PierreHlr/nfc-business-card/Carte_NFC_KiCad/production/bom.csv

Designator | Footprint | Quantity | Value | LCSC Part #
C1, C2 | 0603 | 2 | DNP
U1 | NXP_HXSON-4-1EP_1.5x2mm_P0.5mm | 1 | NT2H1311F0DTLH | C2654853
