PierreHlr/nfc-business-card/Carte_NFC_KiCad/Carte_NFC_KiCad.kicad_pcb

## KiCad design Carte_NFC_KiCad/Carte_NFC_KiCad.kicad_pcb (2026-09-30)

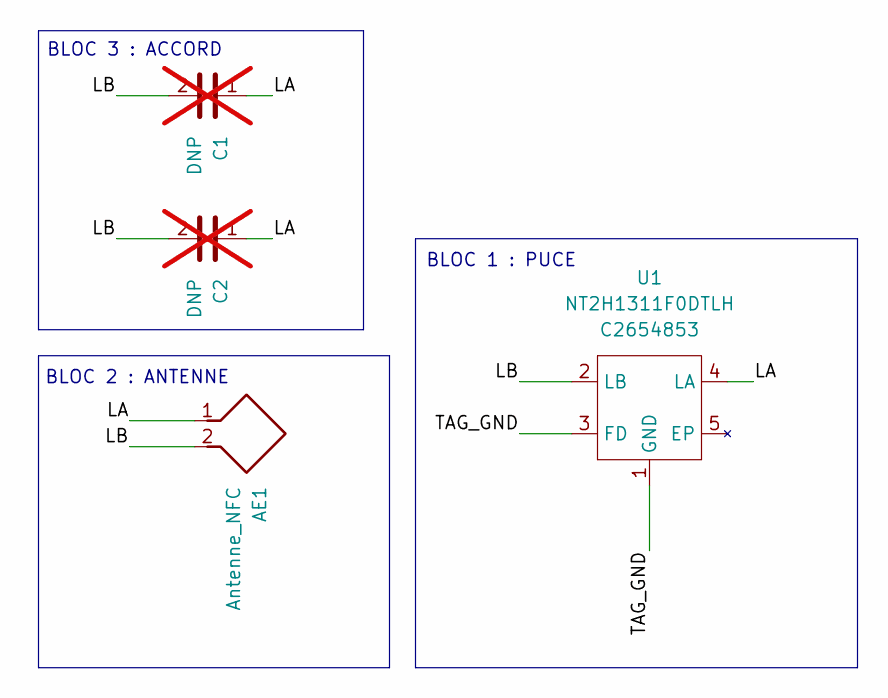
[picture p4: schematic Carte_NFC_KiCad.kicad_sch, Carte NFC]

Parts:
AE1: Antenne_NFC; Antenne_NFC_80x48mm_4T
C1, C2: DNP; C_0603_1608Metric; not fitted
U1: NT2H1311F0DTLH; NXP_HXSON-4-1EP_1.5x2mm_P0.5mm; LCSC C2654853

Connections:
/LA: AE1.1, C1.1, C2.1, U1.4 (LA)
/LB: AE1.2, C1.2, C2.2, U1.2 (LB)
/TAG_GND: U1.1 (GND), U1.3 (FD)

Notes on the sheet:
BLOC 2 : ANTENNE
BLOC 3 : ACCORD
BLOC 1 : PUCE

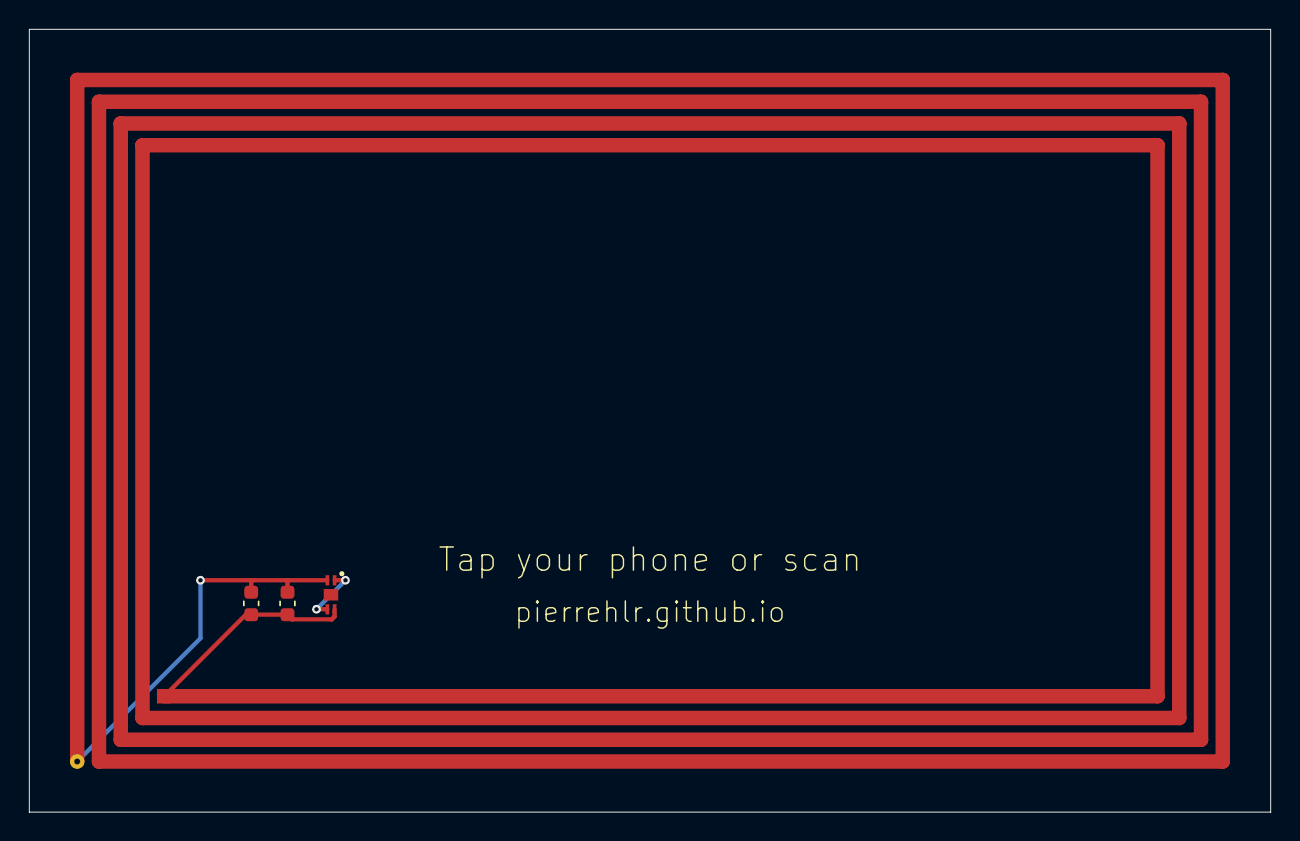
[picture p5: board Carte_NFC_KiCad.kicad_pcb from above]

Board: 2 copper layers, 85.6 x 54.0 mm, 4 parts (0 on the bottom side), 3 nets.
